KavinPalanichamy/BachelorThesis/assets/img/7_1.jpg

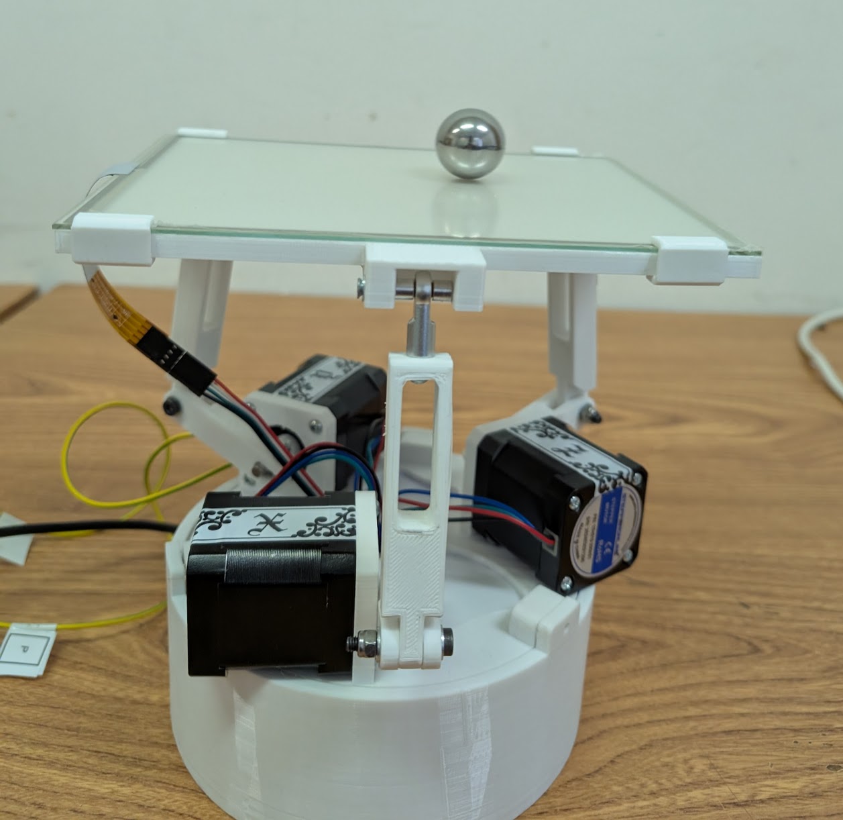
assets/img/7_1.jpg
