KavinPalanichamy/BachelorThesis/Plots/1.png

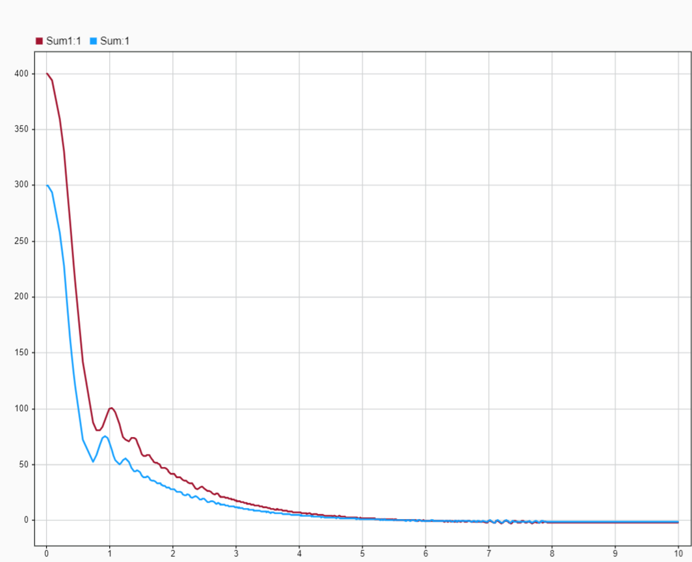
Plots/1.png
