KavinPalanichamy/BachelorThesis/Plots/Circle.png

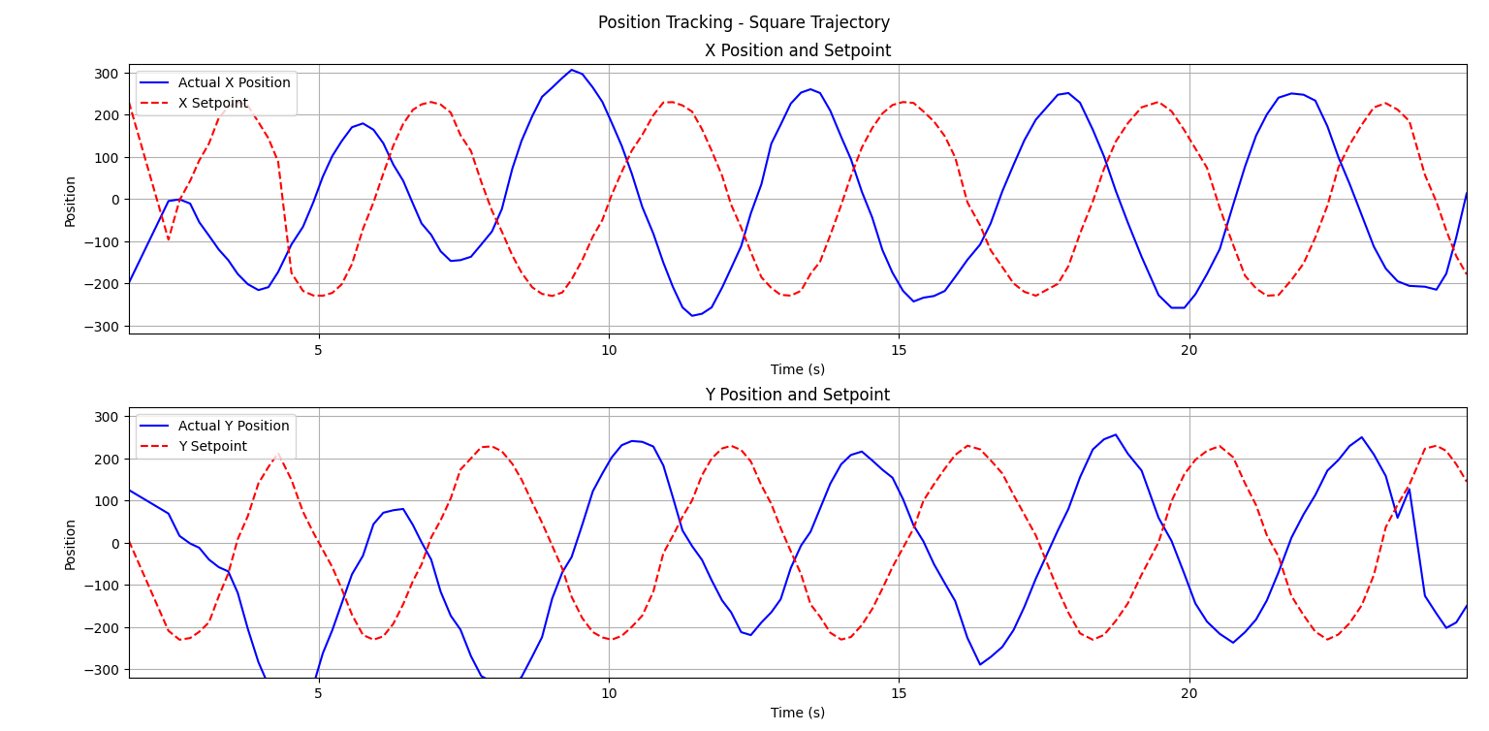
Plots/Circle.png
