KavinPalanichamy/BachelorThesis/Plots/Circle_Tr.png

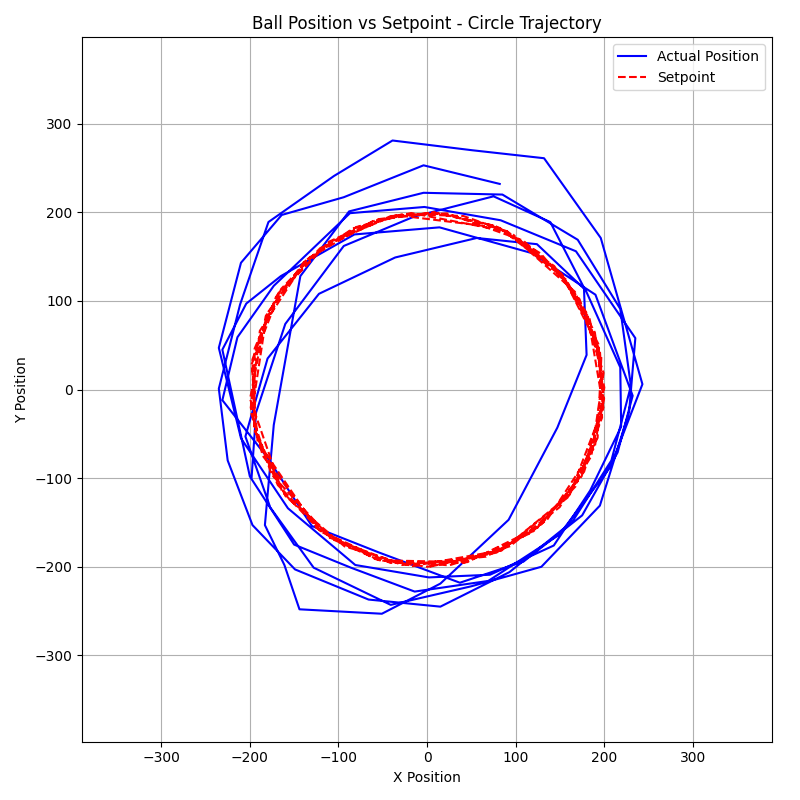
Plots/Circle_Tr.png
