KavinPalanichamy/BachelorThesis/Plots/disturbance.png

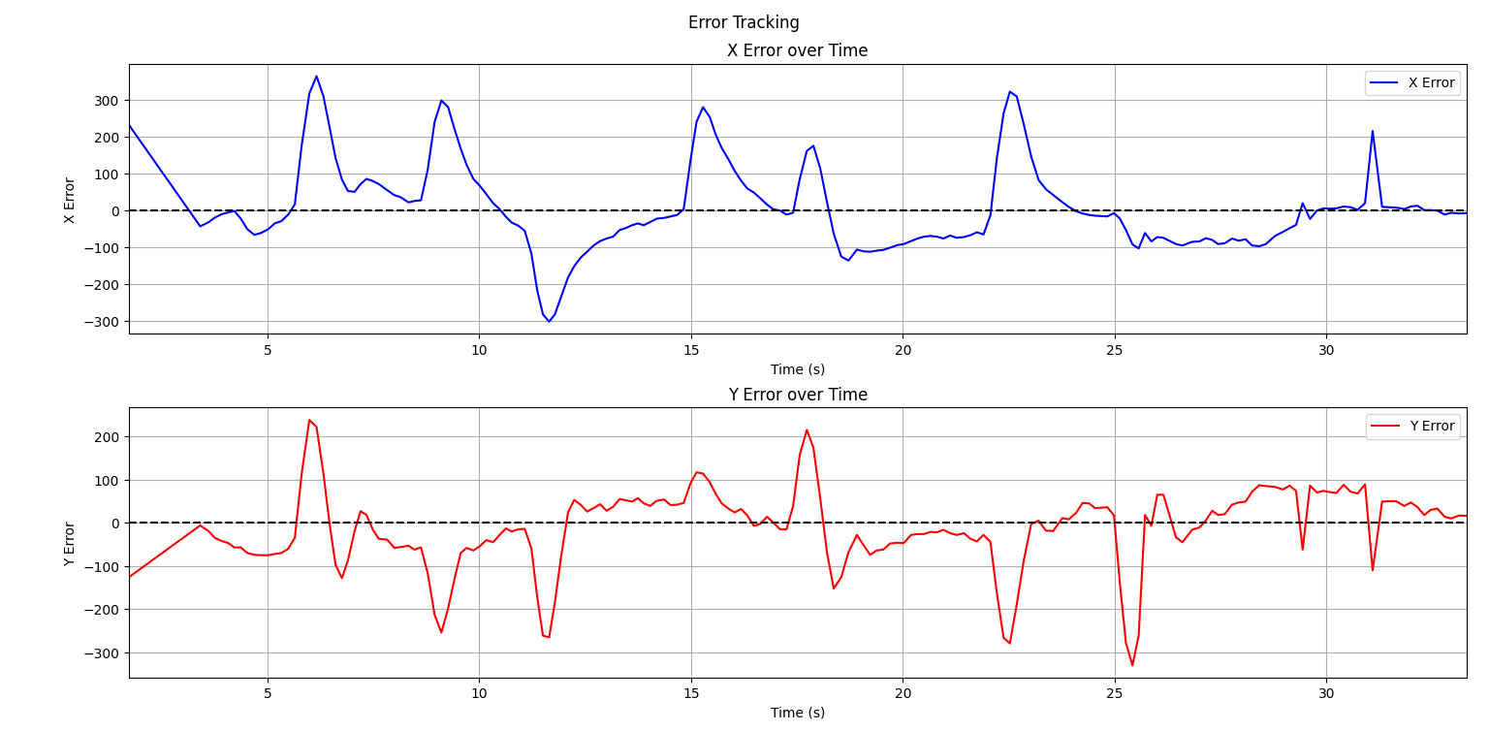
Plots/disturbance.png
