KavinPalanichamy/BachelorThesis/Plots/Figure_1.png

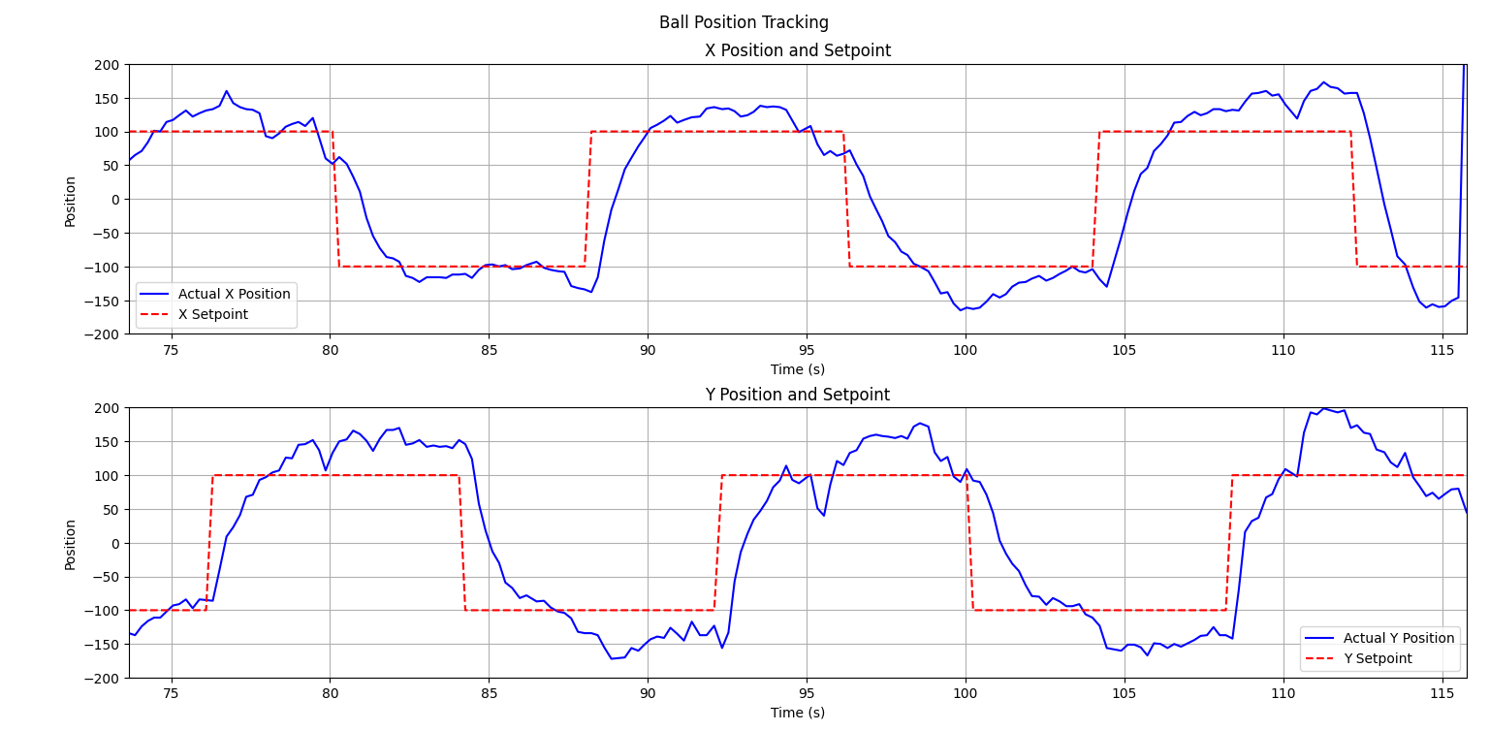
Plots/Figure_1.png
