KavinPalanichamy/BachelorThesis/Plots/Figure_2.png

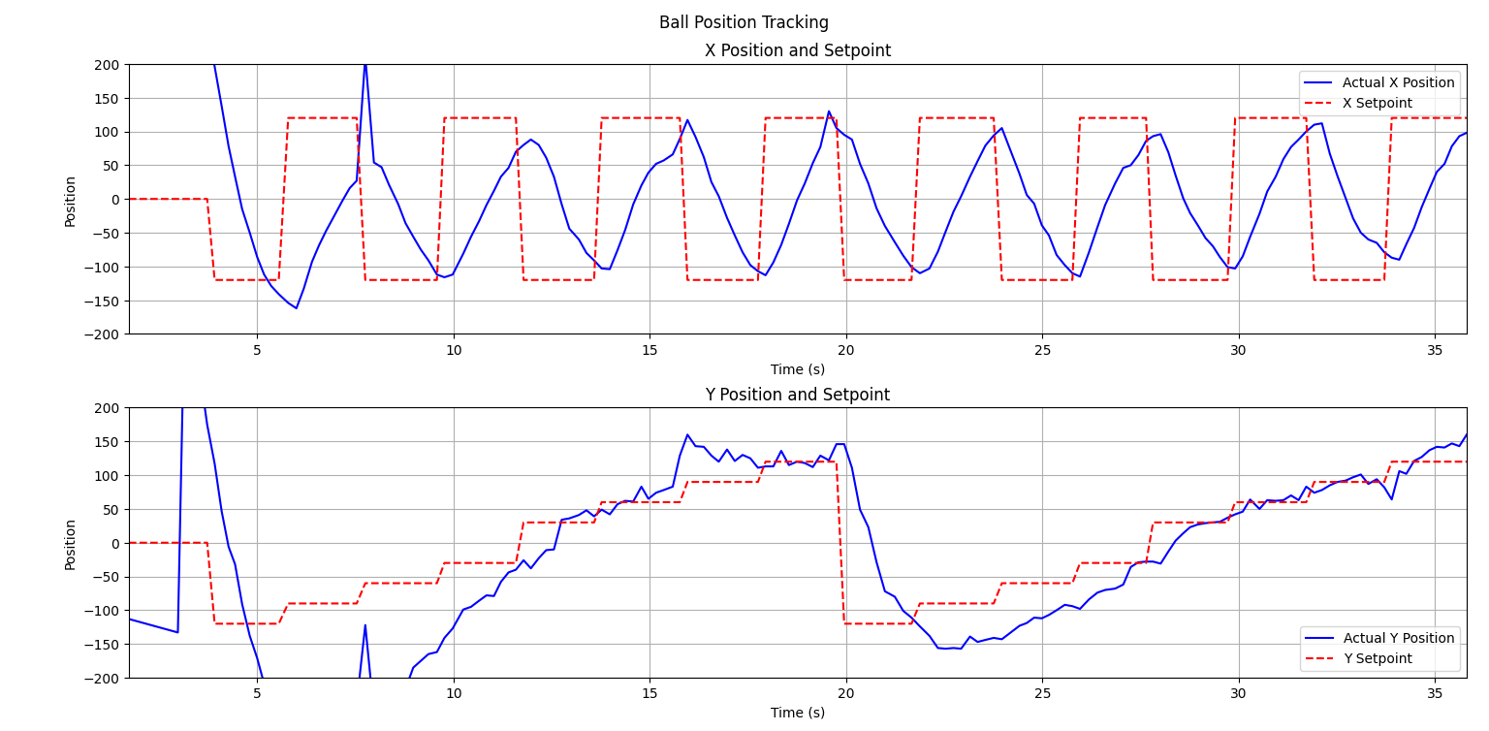
Plots/Figure_2.png
