KavinPalanichamy/BachelorThesis/Plots/Inf2.png

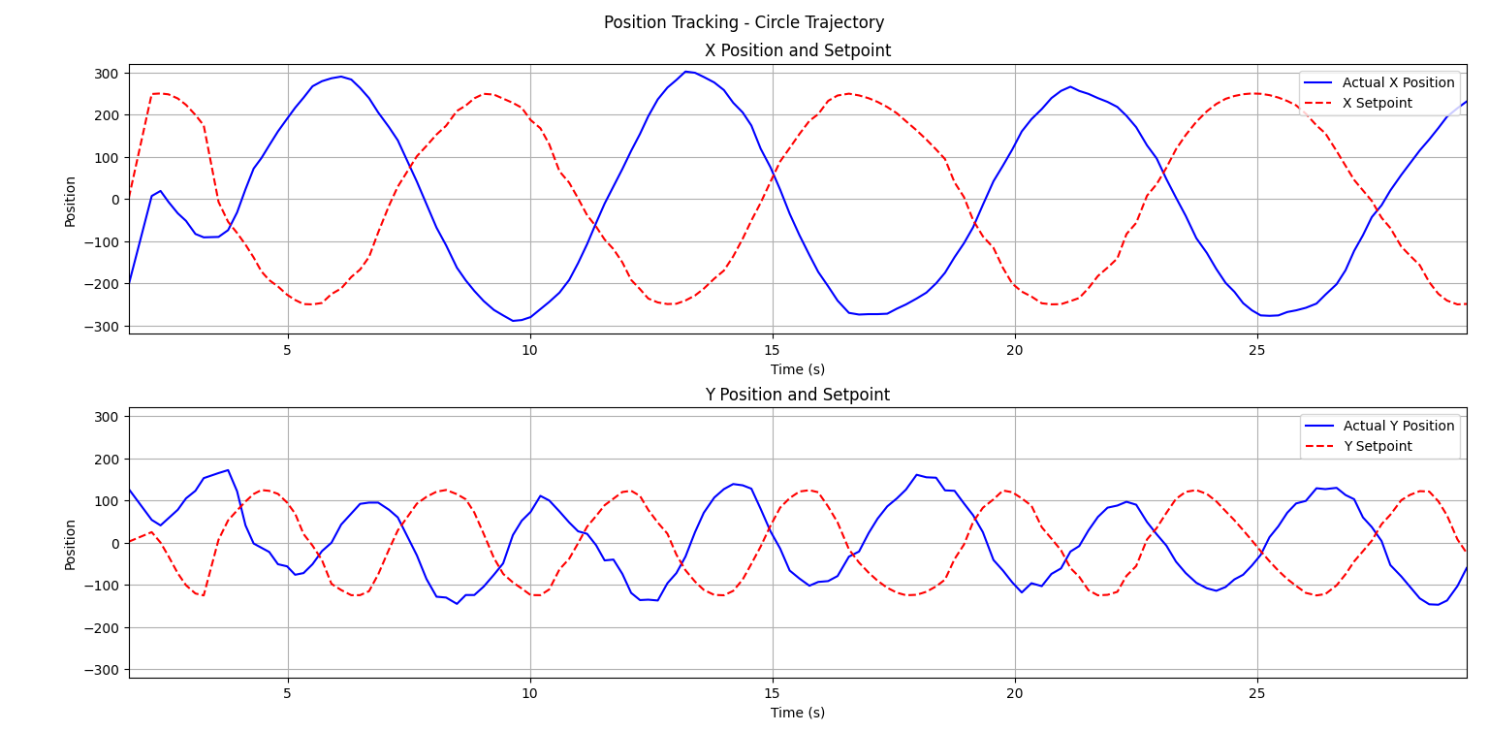
Plots/Inf2.png
