KavinPalanichamy/BachelorThesis/Plots/Infi2.png

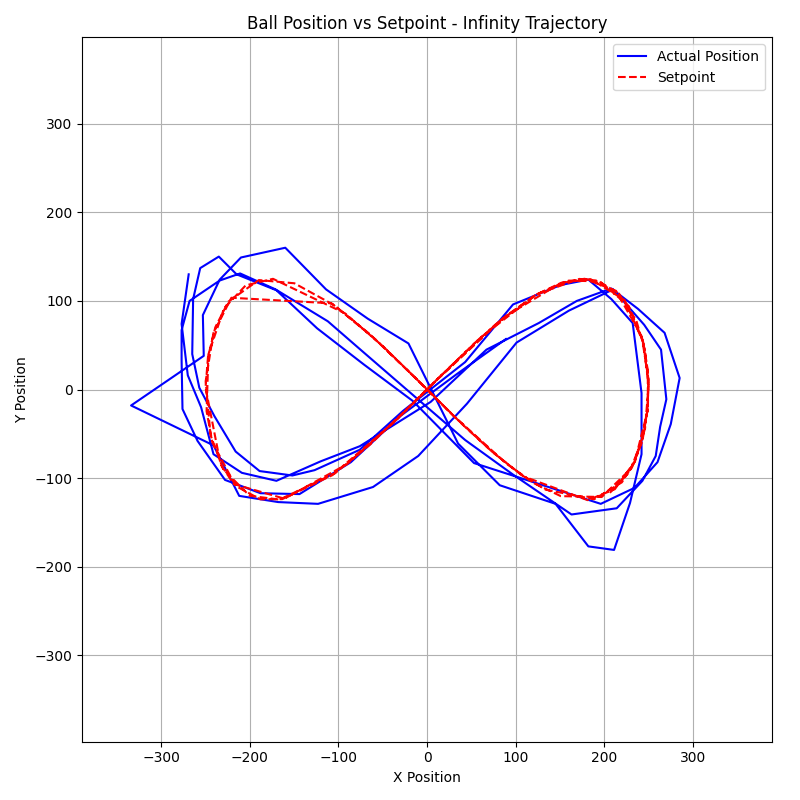
Plots/Infi2.png
