KavinPalanichamy/BachelorThesis/Plots/Infinity.png

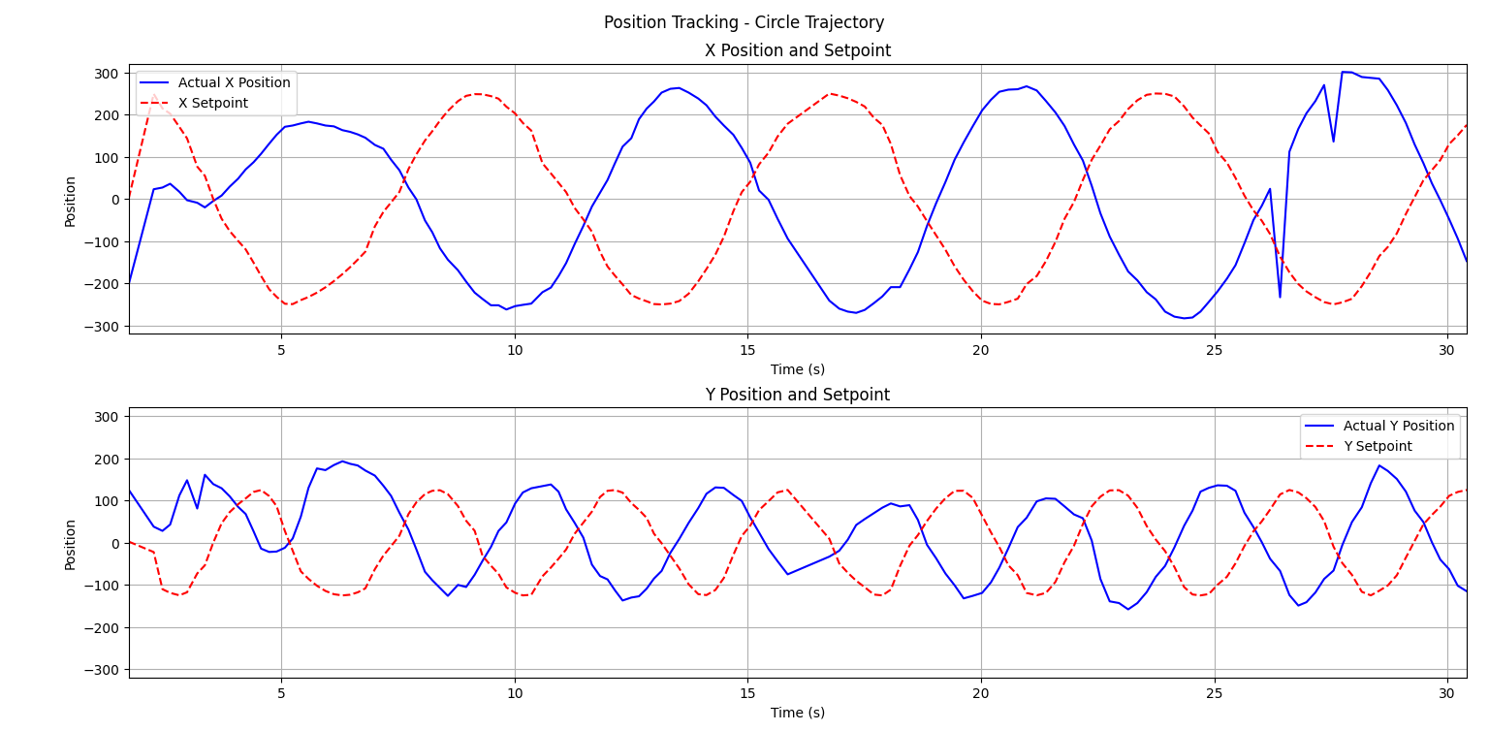
Plots/Infinity.png
