KavinPalanichamy/BachelorThesis/Plots/LagFrequency.png

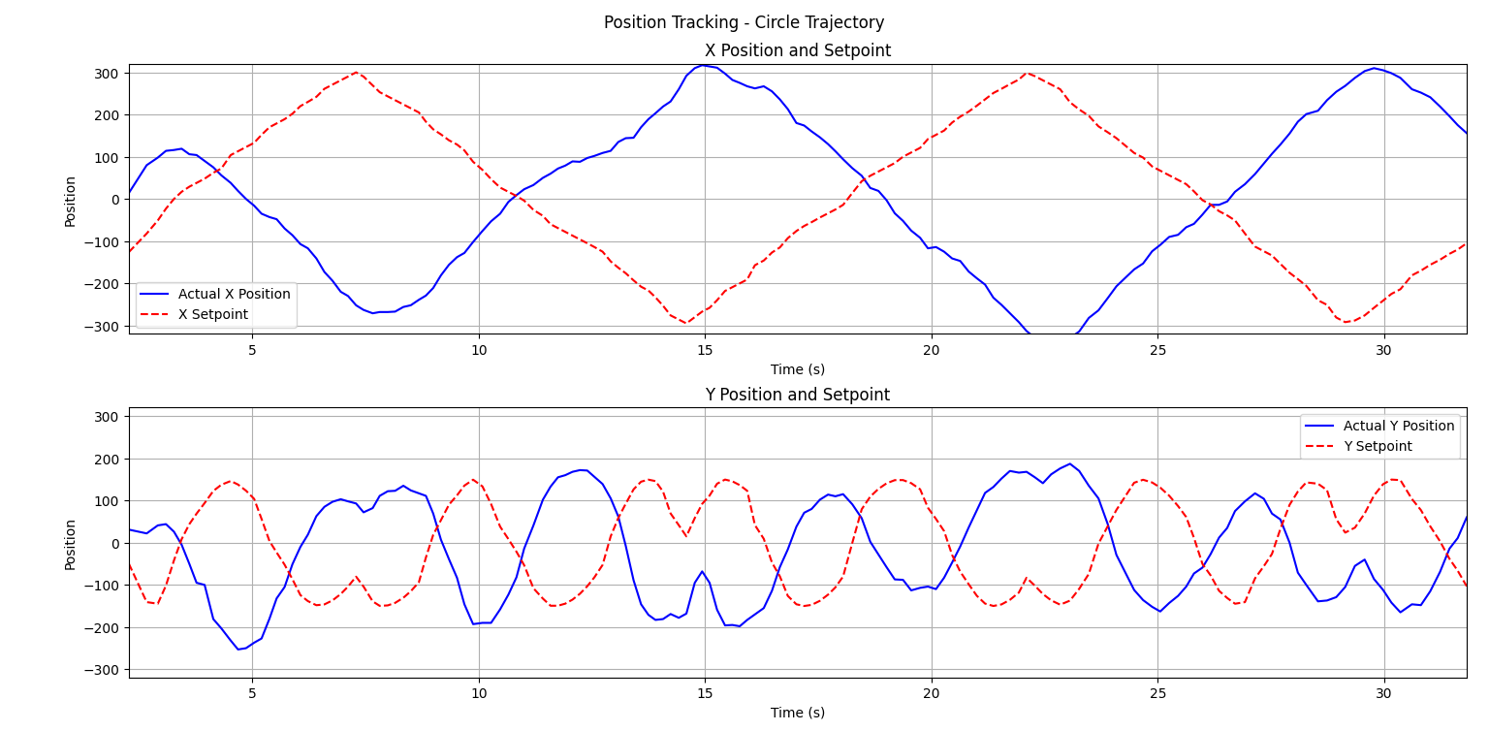
Plots/LagFrequency.png
