KavinPalanichamy/BachelorThesis/Plots/M1.png

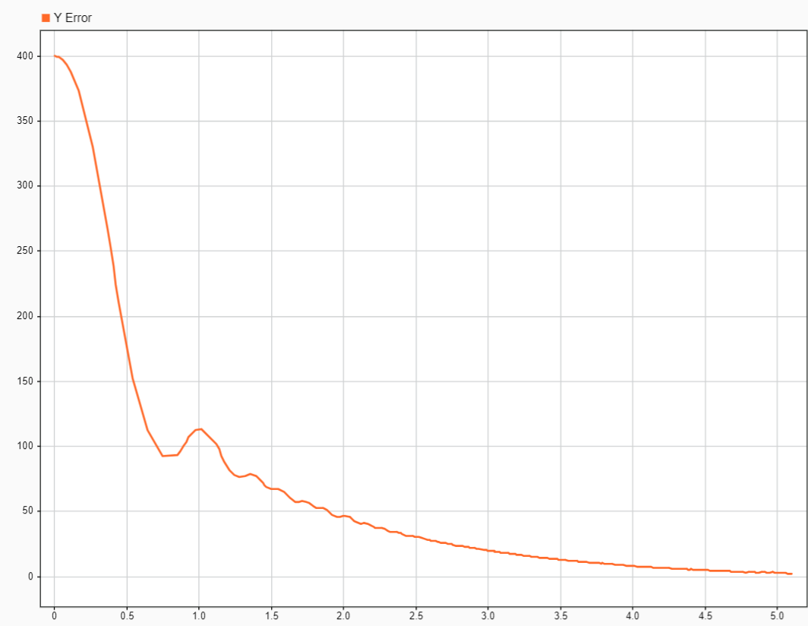
Plots/M1.png
