KavinPalanichamy/BachelorThesis/Plots/PXL_20241228_180311139.jpg

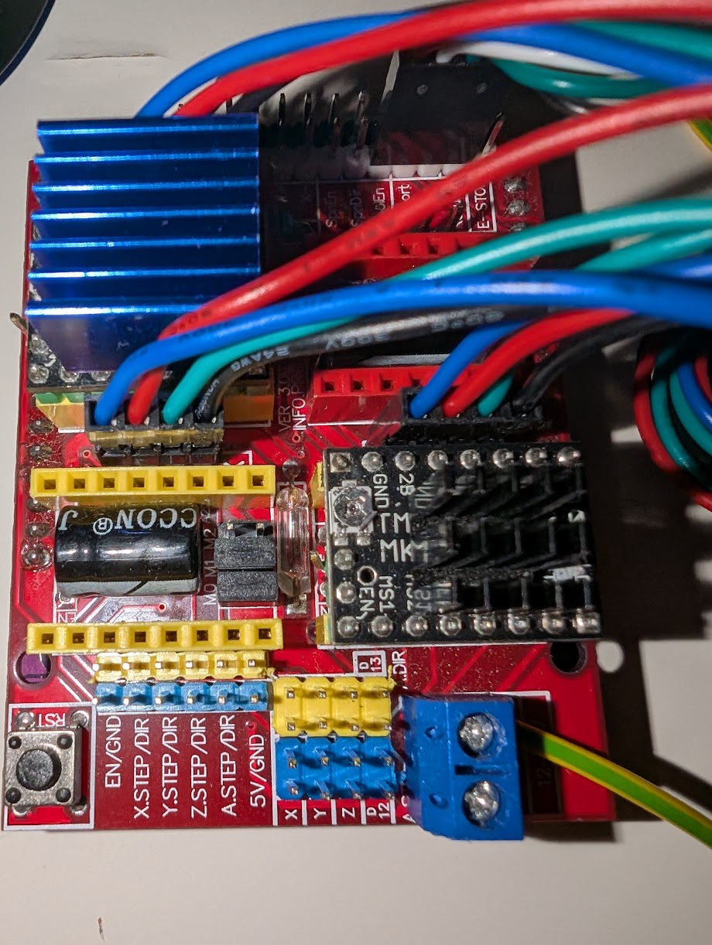
Plots/PXL_20241228_180311139.jpg
