KavinPalanichamy/BachelorThesis/Plots/RawErrorX_vs_NormX.png

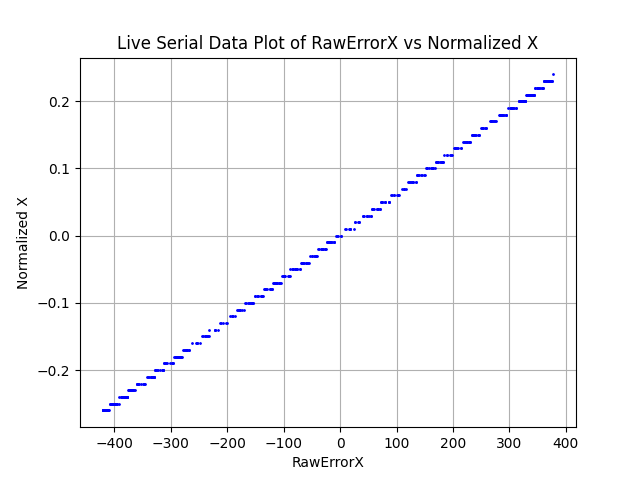
Plots/RawErrorX_vs_NormX.png
