KavinPalanichamy/BachelorThesis/Plots/RawErrorY_vs_NormY.png

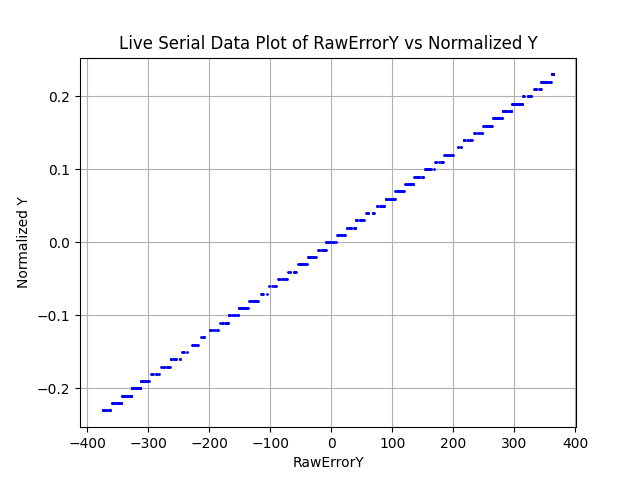
Plots/RawErrorY_vs_NormY.png
