KavinPalanichamy/BachelorThesis/Plots/Square.png

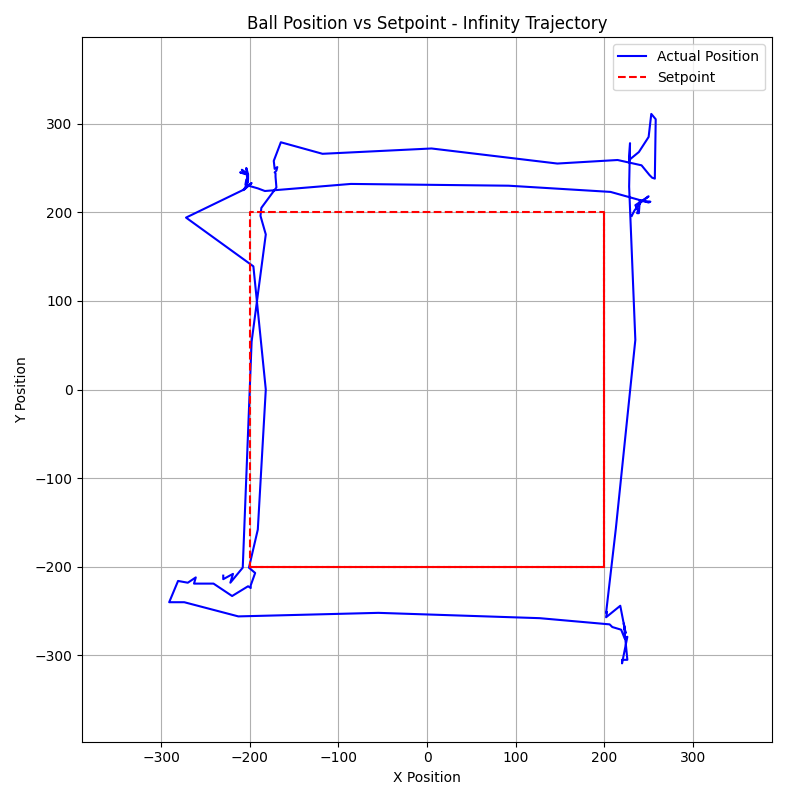
Plots/Square.png
