KavinPalanichamy/BachelorThesis/Plots/Tune_1.png

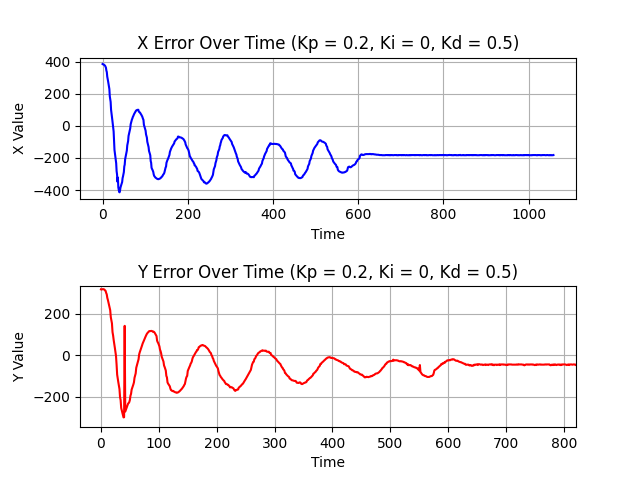
Plots/Tune_1.png
