KavinPalanichamy/BachelorThesis/Plots/Tune_2.png

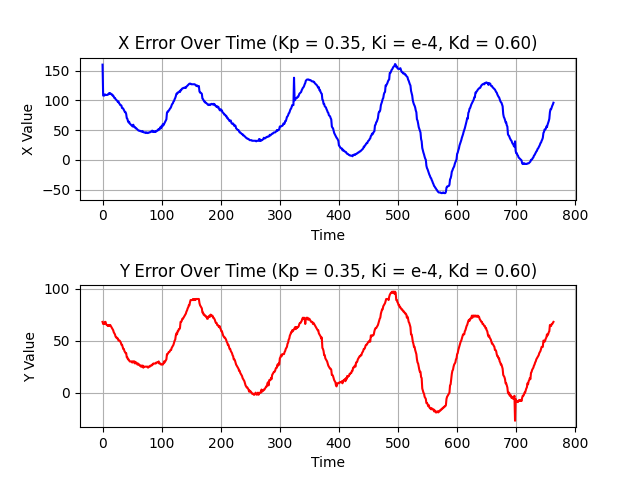
Plots/Tune_2.png
