KavinPalanichamy/BachelorThesis/Plots/Tune_3.png

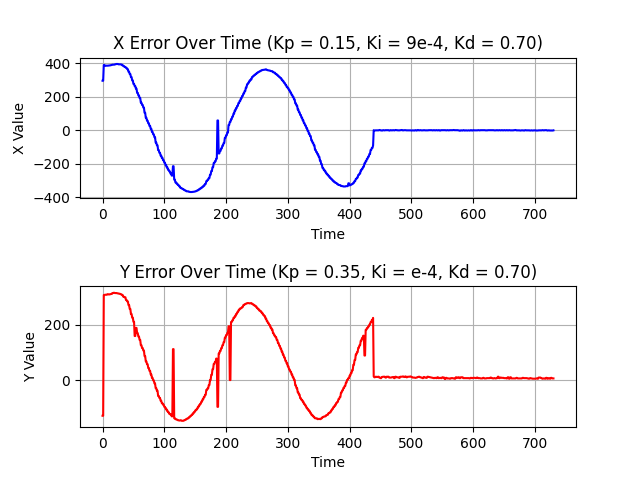
Plots/Tune_3.png
