KavinPalanichamy/BachelorThesis/(commit log)

2024-12-19 Add touch screen functionality and stepper motor control to the Ball Balancer project
2024-12-21 Refactor Thesis document and enhance viewer script with improved plotting and serial reading; add stepper motor control code for Ball Balancer project
2024-12-28 Add CSV generation script and enhance Ball Balancer functionality with improved PID control and touchscreen integration
    [data.csv]
2024-12-31 Add viewer script for serial data plotting with error visualization and refactor existing viewer
    [ard.ino, viewer.py, viewer2.py]
2025-01-06 Refactor PID constants and enhance path update functions; improve viewer script for better data visualization
2025-01-07 Refactor path update functions and add new viewer scripts for error tracking and position visualization
    [ard.ino, viewer2.py, viewer3.py]
2025-01-26 Update PID constants for improved control accuracy and modify thesis document
